Joemahoney2/Lab-3Group-6/Group 6 - Main Project 2 -  Autonomous Robot Flag Finder.pptx

Robotic Flag Finder
ECE 3333/3334-302
Instructor: William Ray
Group 6: Leader - Celina

Adam Harper - Software Engineer
Celina Luckevich - Software Engineer

Joseph Mahoney - Software Engineer
Joshua Warren - Software Engineer

## System Description

Two robots are designed to search a room for flags, retrieve the flags, and return to their home base. The robots work both cooperatively and competitively, each trying to find the most flags but ensuring all flags are found. They send video and location feed over a wifi network to a computer where instructions for driving the robots are derived from the video; these instructions are then sent back over the network to the robots. The system works autonomously, but a manual, human-controlled mode is also available.

## Last Week Deliverables

Josh
- Research Computer Vision
- Research and choose robot body

Celina
- Research Computer Vision
- Research image processing and analysis
- Research and choose ultrasonic sensor

Adam
- Research Wireless connection and user interface
- Research and choose camera

Joe
- Research Wireless connection and user interface
- Research arm and choose servo and electromagnet

## Safety Considerations

- Avoiding short circuits, causing overheating.
- Careful to operate robots at a safe speed to avoid damaging parts/people
- Exercise caution to avoid cuts from sharp wire ends
- Covering wires when cutting to keep ends from flying
- Always use proper PPE

## Division of Labor

Josh
- Rover side
- Computer Vision

Celina
- Rover side
- Computer Vision
- Image Processing and Analysis
- Flag finding/Detection

Adam
- Computer side
- Communication between robots and computer
- Communication between camera and computer

Joe
- Computer side
- GUI
- Robotic arm

## Block Diagram

9.6V
2000mAh

5 V Voltage
Regulator

Robot #2 is identical

WIFI

Uart

Physical connection

GPIO

Power

PWM

Power

PC

sensors

Robot #1

Ultrasonic
HC-SR04

3.3 V

CC3220
MCU

Wifi Camera

External rechargeable battery

3.3v

mechanical

5 V

5 V Voltage
Regulator

3.3V

9.6v

Data Computation

3.3 Volt
Regulator

Dagu - Rover 5 chassis motors

HS-422
Survo

9.6 V

3.3v 50 Hz

9 V Voltage
Regulator

Uxcell 9V 50N
Electromagnet

H-Bridge

Circuits

7.2 V

Joe Mahoney

## Texas Instruments CC3220SF

- Wi-Fi Network Processor with static or dynamic IP address
  - IPv6 and TCP/IP capable
  - Automatic connection on startup
- Ideal for IoT
- Uses 5V at 0.5A supply voltage
- 1MB Flash, 256KB RAM
- 12 bit ADC
- 27 GPIO pins
All info from TI [6]

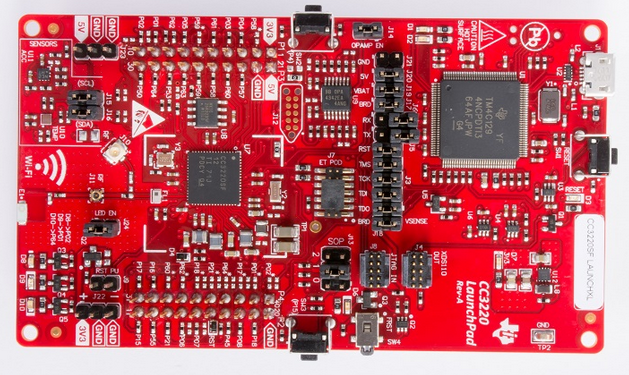
[picture p1: figure]

## Rover Base

- Dagu Rover 5
- Motor Rated Voltage: 7.2V
- Motor Stall Current: 2.5A
- Motor Stall Torque: 10Kg/cm
- Motors have 1000/3 encoders
- Speed: 1Km/hr
All info from Pololu [5]

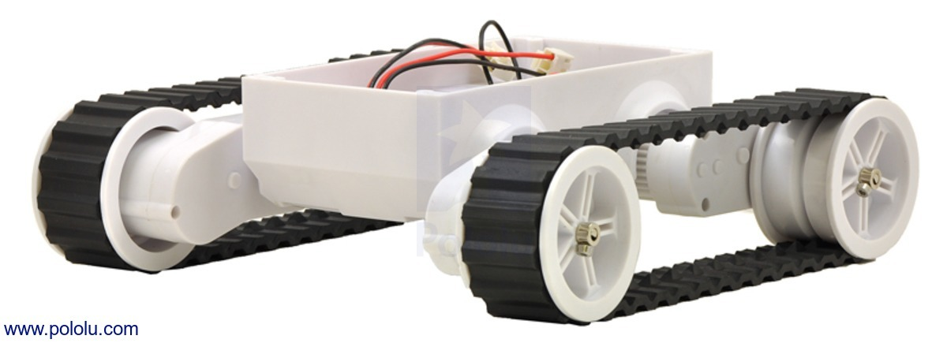
[picture p2: figure]
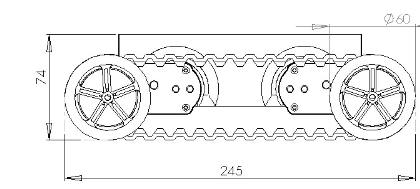
[picture p3: figure]

## Camera - eLinkSmart

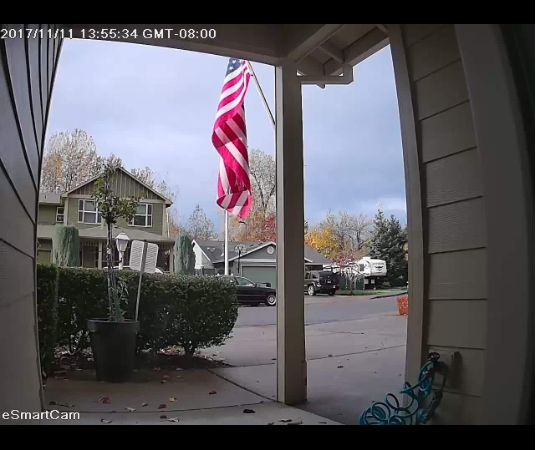
[picture p4: figure]

- IP Camera (WIFI)
- 1280 x 960p
- Rechargeable Battery
- Can be used with app (for testing)
- Connects to openCV using
camera’s IP address as input

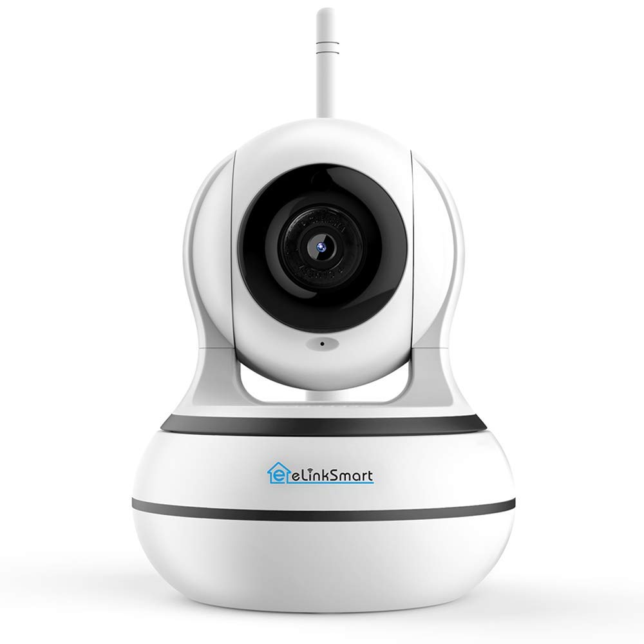
[picture p5: figure]

Images from [1]

## Arm Servo

Servo motor - HS-422
- Operating voltage 4.8 V - 6 V
- 8mA Idle current drain
- .21sec/60 degrees
Electromagnet - uxcell 9V 50N Electric Lifting Magnet
- Holding force 50N / 11.2 pound force

Joe Mahoney

## Arm Servo

- Picking up flags Process
  - Once rover is in position the electromagnet will activate attracting the metal flag pole.
  - Once the flag is secure the servo will rotate a lever arm containing the electromagnet and flag. When the flag is over the bucket/ basket located on the servo side of the rover the magnet will power down releasing the flag.
  - The servo will then reset itself to its starting position.

Joe Mahoney

## Rover Software Diagram

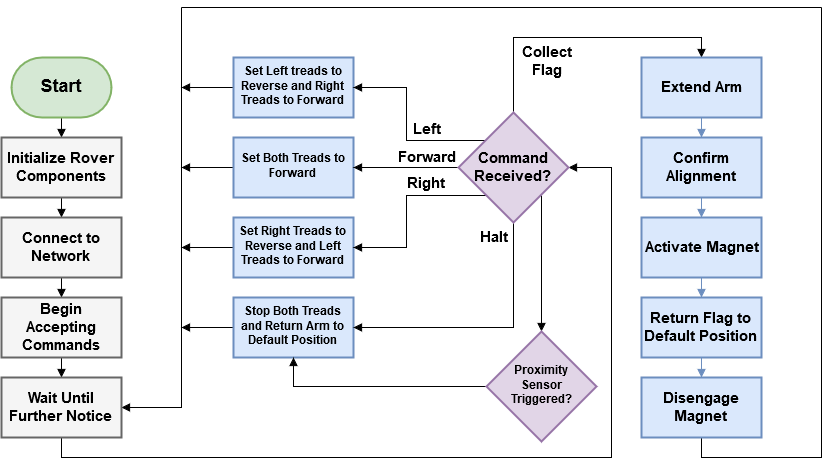
[picture p6: figure]

## Computer Vision

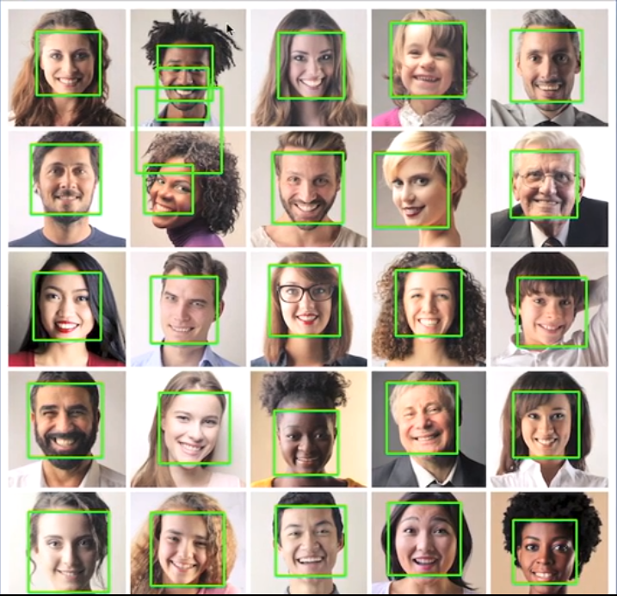
[picture p7: figure]

- Project description requires rover to use camera to view surroundings
- OpenCV has video analyzing features allowing us to scan the rovers surroundings for the flags it is looking for
- Different kinds of filters
- Usually coded in python

[2]

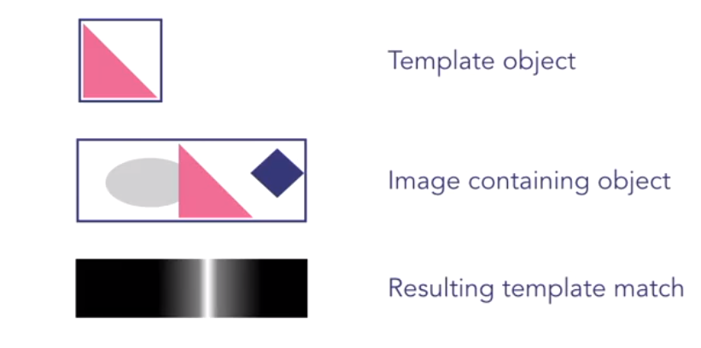
[picture p8: figure]

[2]

## Slide 14

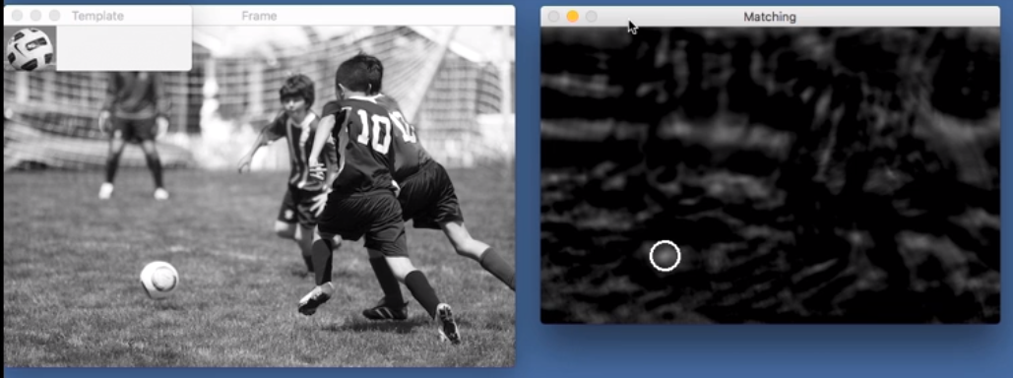
[picture p9: figure]

[2]

## Ultrasonic Sensor - HC-SR04

- Operating Voltage: 5V DC
- Operating Current: 15mA
- Measure Angle: 15°
- Ranging Distance: 2cm - 4m

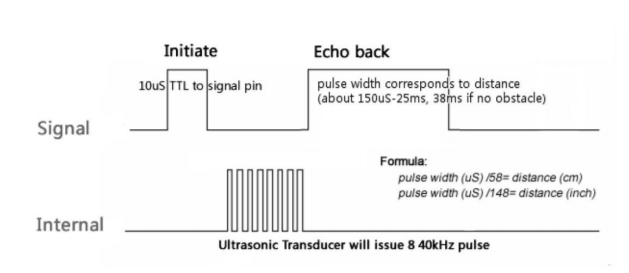
[picture p10: figure]
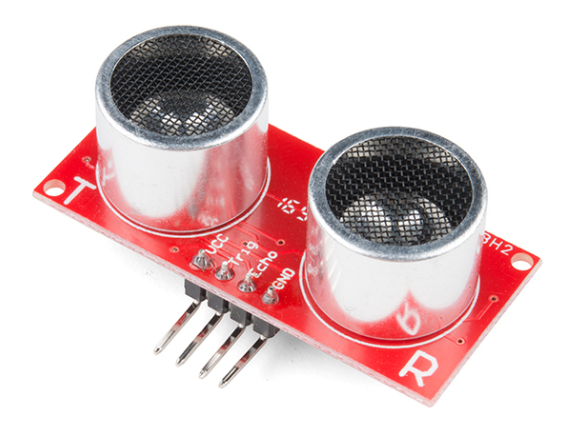
[picture p11: figure]

Range = uS / 58 -> centimeters
Range = uS / 148 -> inches
Range = high level time * velocity (340M/S) / 2
[3]

[3]

[4]

## Gantt Chart - Hardware

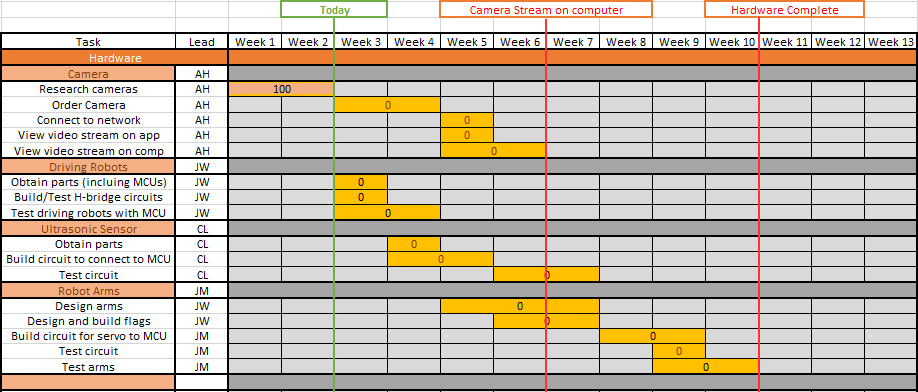
[picture p12: figure]

## Gantt Chart - Software

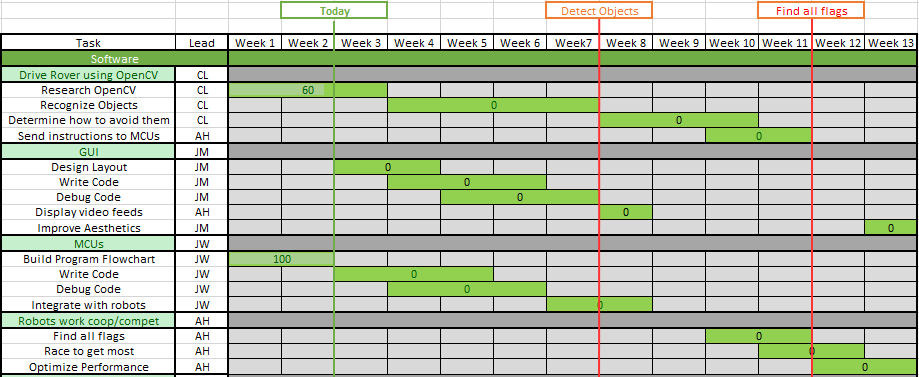
[picture p13: figure]

## Budget

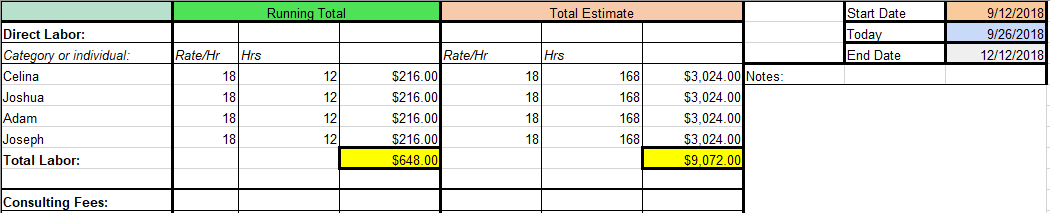
[picture p14: figure]

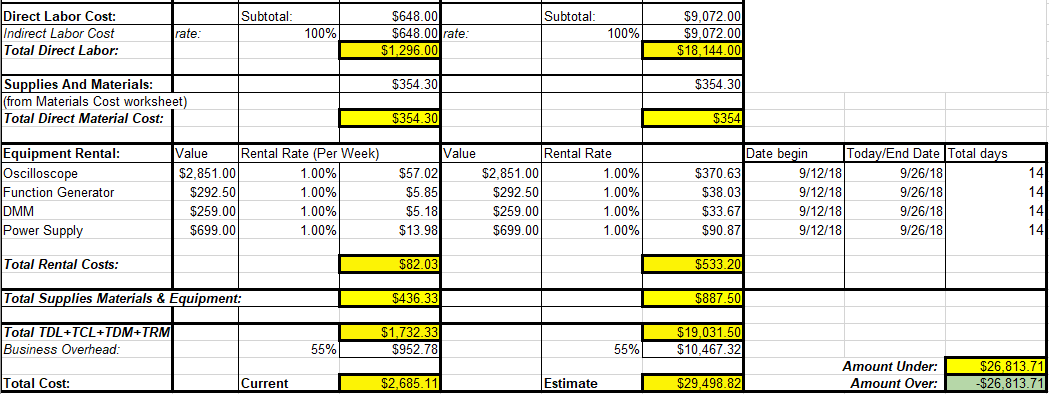
[picture p15: figure]

## Next Week Deliverables

Josh
- Begin simple image processing
- Research into controlling the CC3220 through Wi-Fi.

Celina
- Learn basic Python
- Begin simple image processing and filtering codes

Adam
- Research computer communication with IP Cameras
- Order camera
- Testing camera communication

Joe
- Research creating a user interface and communicating with the CC3220 via wifi.
- Look into displaying a video stream in a GUI

## References

1. eLinkSmart WIFI Camera https://www.amazon.com/Wireless-Security-eLinkSmart-Recording-Detection/dp/B07414BGZC
2. Crawford, P. (2017). Introduction to template matching. [online] Lynda.com - from LinkedIn. Available at: https://www.lynda.com/Python-tutorials/Introduction-template-matching/601786/660495-4.html [Accessed 21 Sep. 2018].
3. Sparkfun.com. (2018). Ultrasonic Sensor - HC-SR04 - SEN-13959 - SparkFun Electronics. [online] Available at: https://www.sparkfun.com/products/13959 [Accessed 23 Sep. 2018].
4. ITead Studio. (2018). Ultrasonic ranging module : HC-SR04 data sheet. [online] Available at: https://www.electroschematics.com/wp-content/uploads/2013/07/HC-SR04-datasheet-version-2.pdf [Accessed 24 Sep. 2018].
5. Pololu.com. (2018). Dagu Rover 5 Tracked Chassis with Encoders. [online] Available at: https://www.pololu.com/product/1551/resources [Accessed 24 Sep. 2018].
6. TI.com. (2018). SimpleLink™ Wi-Fi® CC3220SF Wireless Microcontroller. [online] Available at: http://www.ti.com/lit/ds/swas035a/swas035a.pdf [Accessed 24 Sep. 2018].

## Questions?
