Joemahoney2/Lab-3Group-6/ARM_V1V2.PNG

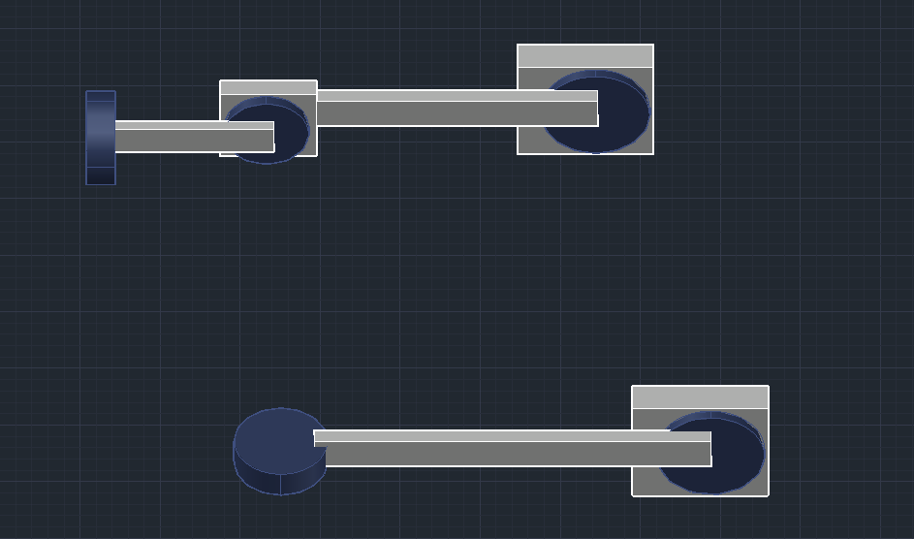
ARM_V1V2.PNG
