Joemahoney2/Lab-3Group-6/front_view.PNG

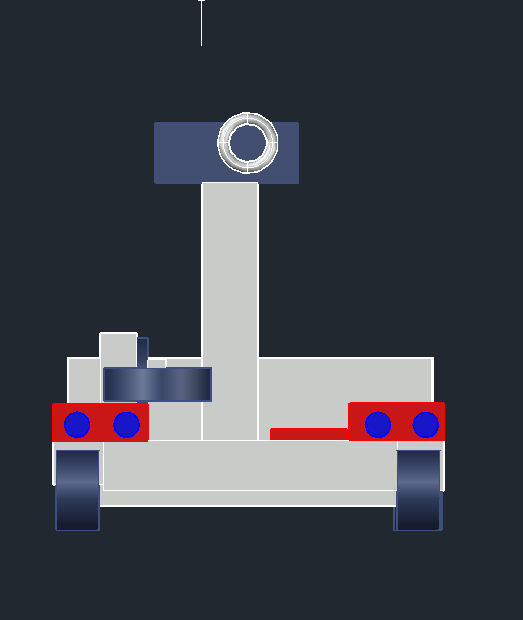
front_view.PNG
