Joemahoney2/Lab-3Group-6/GUI template.png

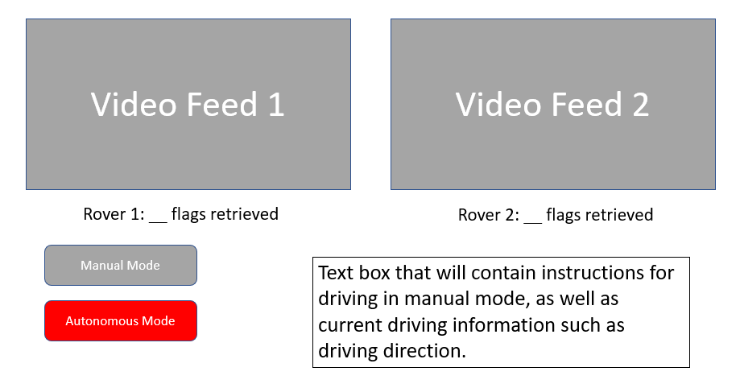
GUI template.png
