Joemahoney2/Lab-3Group-6/power.PNG

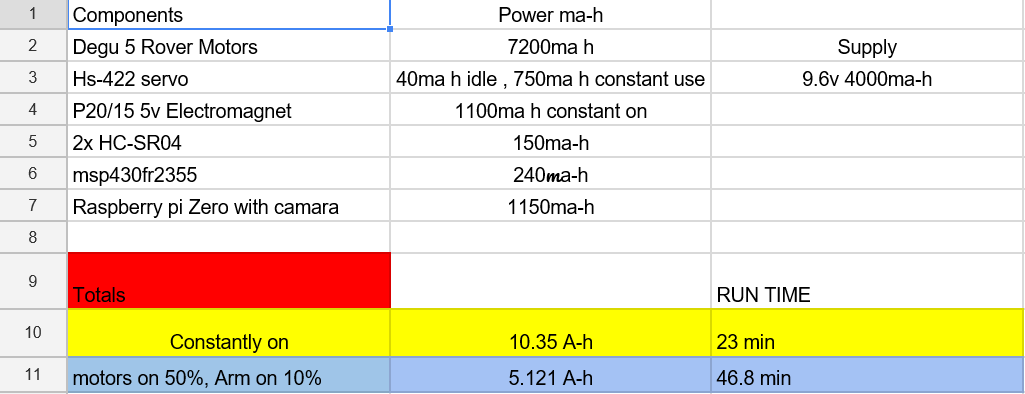
power.PNG
