Joemahoney2/Lab-3Group-6/top_view.PNG

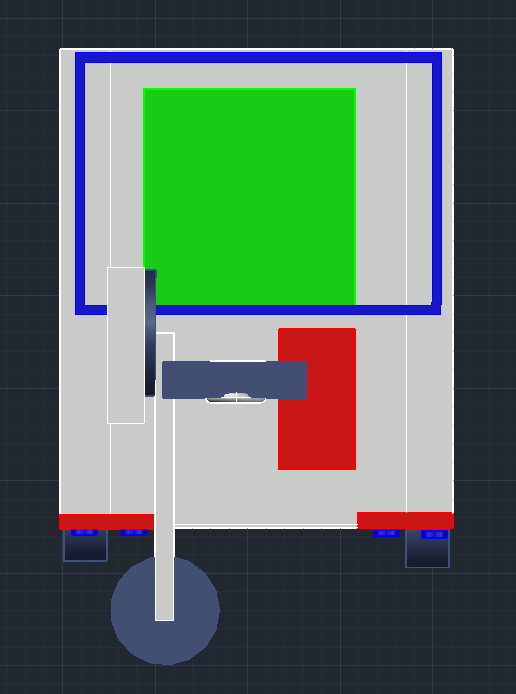
top_view.PNG
