Joemahoney2/Lab-3Group-6/uperleft_view.PNG

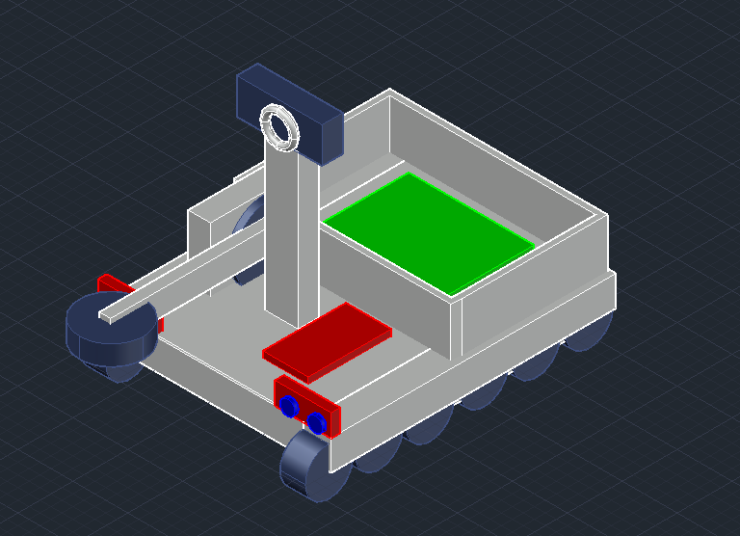
uperleft_view.PNG
