Joemahoney2/Lab-3Group-6/List of parts.docx

Rover body

- https://www.amazon.com/Dagu-Rover-5-Tracked-Chassis/dp/B012NNLW5I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
- https://www.amazon.com/DLBOT-Aluminum-All-Metal-Obstacle-surmounting-Detection/dp/B07H7HTBFJ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
- We can checkout a Dagu rover 5 body from the stockroom

Electromagnet

https://www.adafruit.com/product/3872

Arm servo

- https://www.amazon.com/Hitec-RCD-USA-31422-Standard/dp/B00B88FIZ0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
- Or we could go all out: https://www.amazon.com/LewanSoul-Real-Time-Feedback-Bearing-Brackets/dp/B0748BQ49M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

Microcontroller

- Simplelink CC3220
- Certainly open to suggestions

Ultrasonic sensor

- ??
- https://www.sparkfun.com/products/9494 2x??
- https://www.sparkfun.com/products/13959

Wifi Camera

- https://www.amazon.com/Wireless-Security-eLinkSmart-Recording-Detection/dp/B07414BGZC
- https://www.newegg.com/Product/Product.aspx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
- https://www.amazon.com/dp/B0762MB2TD/ref=cm_sw_r_other_apa_Cf9QBbMNS8AYN

Rover battery/rechargeable

- https://www.amazon.com/Tenergy-Capacity-Rechargeable-Batteries-Connector/dp/B001BBMZFU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
