Joemahoney2/Lab-3Group-6/Budget.xlsx

Sheet: Sheet1
 | Running Total |  |  | Total Estimate |  |  |  | Start Date | 2018-09-12
Direct Labor: |  |  |  |  |  |  |  | Today | 2018-10-03
Category or individual: | Rate/Hr | Hrs |  | Rate/Hr | Hrs |  |  | End Date | 2018-12-12
Celina | 18 | 40 | $720.00 | 18 | 168 | $3024.00 | Notes:
Joshua | 18 | 40 | $720.00 | 18 | 168 | $3024.00
Adam | 18 | 39 | $702.00 | 18 | 168 | $3024.00
Joseph | 18 | 31 | $558.00 | 18 | 168 | $3024.00
Total Labor: |  |  | $2142.00 |  |  | $9072.00
Consulting Fees:
Category or individual: | Rate/Hr | Hrs |  | Rate/Hr | Hrs
Lab I | 15 | 0 | $0.00 | 15 | 0 | $0.00
Lab II | 18 | 0 | $0.00 | 20 | 0 | $0.00
Lab III | 18 | 0 | $0.00 | 25 | 2 | $50.00
Lab IV & V | 25 | 1 | $25.00 | 35 | 5 | $175.00
Lab Tutors | 40 | 0 | $0.00 | 40 | 0 | $0.00
Lab Assistants | 40 | 0 | $0.00 | 40 | 0 | $0.00
Mr. Woodcock | 100 | 0 | $0.00 | 100 | 0 | $0.00
Instructor | 200 | 0 | $0.00 | 200 | 2 | $400.00
Total Contract Labor: |  |  | $25.00 |  |  | $625.00
Direct Labor Cost: |  | Subtotal: | $2142.00 |  | Subtotal: | $9072.00
Indirect Labor Cost | rate: | 100% | $2142.00 | rate: | 100% | $9072.00
Total Direct Labor: |  |  | $4284.00 |  |  | $18144.00
Supplies And Materials: |  |  | $342.30 |  |  | $342.30
(from Materials Cost worksheet)
Total Direct Material Cost: |  |  | $342.30 |  |  | $342.3
Equipment Rental: | Value | Rental Rate (Per Week) |  | Value | Rental Rate |  | Date begin | Today/End Date | Total days
Oscilloscope | $2851.00 | 1.00% | $85.53 | $2851.00 | 1.00% | $370.63 | 2018-09-12 | 2018-10-03 | 21
Function Generator | $292.50 | 1.00% | $8.78 | $292.50 | 1.00% | $38.02 | 2018-09-12 | 2018-10-03 | 21
DMM | $259.00 | 1.00% | $7.77 | $259.00 | 1.00% | $33.67 | 2018-09-12 | 2018-10-03 | 21
Power Supply | $699.00 | 1.00% | $20.97 | $699.00 | 1.00% | $90.87 | 2018-09-12 | 2018-10-03 | 21
Total Rental Costs: |  |  | $123.05 |  |  | $533.20
Total Supplies Materials & Equipment: |  |  | $465.35 |  |  | $875.50
Total TDL+TCL+TDM+TRM |  |  | $4749.35 |  |  | $19019.49
Business Overhead: |  | 55% | $2612.14 |  | 55% | $10460.72
 |  |  |  |  |  |  | Amount Under: |  | $22118.73
Total Cost: |  | Current | $7361.48 |  | Estimate | $29480.22 | Amount Over: |  | -$22118.73

Sheet: Materials Cost
Item | Cost | Quantity | Notes/Website | Purchase date | Total | Part Number | Total Cost
Rover Chassis | $40.00 | 2 | amazon.com |  | $80.00 | ROV5-1 | Total Cost
Electromagnet | $3.63 | 2 | amazon.com |  | $7.26 |  | $342.30
Servo | $13.95 | 2 | amazon.com |  | $27.90 | HS-422 (31422)
CC3220 MCU Launchpad | $51.76 | 2 | mouser.com |  | $103.52 | CC3220SF
Ultrasonic Sensor | $9.32 | 2 | robotshop.com |  | $18.64 | HC-SR04
IP Camera | $35.99 | 2 | amazon.com |  | $71.98
Battery Pack | $33.00 | 1 | amazon.com |  | $33.00 | Pack of 2
 |  |  |  |  | $0.00
 |  |  |  |  | $0.00
 |  |  |  |  | $0.00
 |  |  |  |  | $0.00
 |  |  |  |  | $0.00
 |  |  |  |  | $0.00
 |  |  |  |  | $0.00
 |  |  |  |  | $0.00
 |  |  |  |  | $0.00
 |  |  |  |  | $0.00
 |  |  |  |  | $0.00
 |  |  |  |  | $0.00
 |  |  |  |  | $0.00
 |  |  |  |  | $0.00
 |  |  |  |  | $0.00
 |  |  |  |  | $0.00
 |  |  |  |  | $0.00
 |  |  |  |  | $0.00
 |  |  |  |  | $0.00
 |  |  |  |  | $0.00
 |  |  |  |  | $0.00
 |  |  |  |  | $0.00
 |  |  |  |  | $0.00
 |  |  |  |  | $0.00
 |  |  |  |  | $0.00
 |  |  |  |  | $0.00
 |  |  |  |  | $0.00
 |  |  |  |  | $0.00
 |  |  |  |  | $0.00
 |  |  |  |  | $0.00
 |  |  |  |  | $0.00
 |  |  |  |  | $0.00
 |  |  |  |  | $0.00
 |  |  |  |  | $0.00
 |  |  |  |  | $0.00
 |  |  |  |  | $0.00
 |  |  |  |  | $0.00
 |  |  |  |  | $0.00
 |  |  |  |  | $0.00
 |  |  |  |  | $0.00
 |  |  |  |  | $0.00
 |  |  |  |  | $0.00
 |  |  |  |  | $0.00
 |  |  |  |  | $0.00
 |  |  |  |  | $0.00
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
 |  |  |  |  | $0.00
 |  |  |  |  | $0.00
 |  |  |  |  | $0.00
 |  |  |  |  | $0.00
 |  |  |  |  | $0.00
 |  |  |  |  | $0.00
 |  |  |  |  | $0.00
 |  |  |  |  | $0.00
 |  |  |  |  | $0.00
 |  |  |  |  | $0.00
 |  |  |  |  | $0.00
 |  |  |  |  | $0.00
 |  |  |  |  | $0.00
 |  |  |  |  | $0.00

Sheet: Labor Hours
 | Celina | Joshua | Adam | Joseph | Lab I | Lab II | Lab III | Lab IV & V | Lab Tutors | Lab Assistants | Mr. Woodcock | Instructor |  | Total Hours
2018-09-12 | 0 | 0 | 0 | 0 | 0 | 0 | 0 | 0 | 0 | 0 | 0 | 0 | Celina | 40
2018-09-13 | 0 | 0 | 0 | 0 | 0 | 0 | 0 | 0 | 0 | 0 | 0 | 0 | Joshua | 40
2018-09-14 | 0 | 0 | 0 | 0 | 0 | 0 | 0 | 0 | 0 | 0 | 0 | 0 | Adam | 39
2018-09-15 | 0 | 0 | 0 | 0 | 0 | 0 | 0 | 0 | 0 | 0 | 0 | 0 | Joseph | 36
2018-09-16 | 0 | 0 | 0 | 0 | 0 | 0 | 0 | 0 | 0 | 0 | 0 | 0 | Lab I | 0
2018-09-17 | 0 | 0 | 0 | 0 | 0 | 0 | 0 | 0 | 0 | 0 | 0 | 0 | Lab II | 0
2018-09-18 | 0 | 0 | 0 | 0 | 0 | 0 | 0 | 0 | 0 | 0 | 0 | 0 | Lab III | 0
2018-09-19 | 0 | 0 | 0 | 0 | 0 | 0 | 0 | 0 | 0 | 0 | 0 | 0 | Lab IV & V | 1
2018-09-20 | 0 | 0 | 0 | 0 | 0 | 0 | 0 | 0 | 0 | 0 | 0 | 0 | Lab Tutors | 0
2018-09-21 | 0 | 0 | 0 | 0 | 0 | 0 | 0 | 0 | 0 | 0 | 0 | 0 | Lab Assistants | 0
2018-09-22 | 0 | 0 | 0 | 0 | 0 | 0 | 0 | 0 | 0 | 0 | 0 | 0 | Mr. Woodcock | 0
2018-09-23 | 0 | 0 | 0 | 0 | 0 | 0 | 0 | 0 | 0 | 0 | 0 | 0 | Instructor | 0
2018-09-24 | 0 | 0 | 0 | 0 | 0 | 0 | 0 | 0 | 0 | 0 | 0 | 0
2018-09-25 | 0 | 0 | 0 | 0 | 0 | 0 | 0 | 0 | 0 | 0 | 0 | 0
2018-09-26 | 12 | 12 | 12 | 12 | 0 | 0 | 0 | 0 | 0 | 0 | 0 | 0
2018-09-27 | 0 | 0 | 3 | 0 | 0 | 0 | 0 | 0 | 0 | 0 | 0 | 0
2018-09-28 | 4 | 0 | 0 | 0 | 0 | 0 | 0 | 0 | 0 | 0 | 0 | 0
2018-09-29 | 5 | 0 | 0 | 0 | 0 | 0 | 0 | 0 | 0 | 0 | 0 | 0
2018-09-30 | 0 | 0 | 0 | 0 | 0 | 0 | 0 | 0 | 0 | 0 | 0 | 0
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
2018-12-08 | 0 | 0 | 0 | 0 | 0 | 0 | 0 | 0 | 0 | 0 | 0 | 0
2018-12-09 | 0 | 0 | 0 | 0 | 0 | 0 | 0 | 0 | 0 | 0 | 0 | 0
2018-12-10 | 0 | 0 | 0 | 0 | 0 | 0 | 0 | 0 | 0 | 0 | 0 | 0
2018-12-11 | 0 | 0 | 0 | 0 | 0 | 0 | 0 | 0 | 0 | 0 | 0 | 0
2018-12-12 | 0 | 0 | 0 | 0 | 0 | 0 | 0 | 0 | 0 | 0 | 0 | 0
