Joemahoney2/Lab-3Group-6/L3G6_PCB.brd

## EAGLE design L3G6_PCB.brd (2018-11-16)

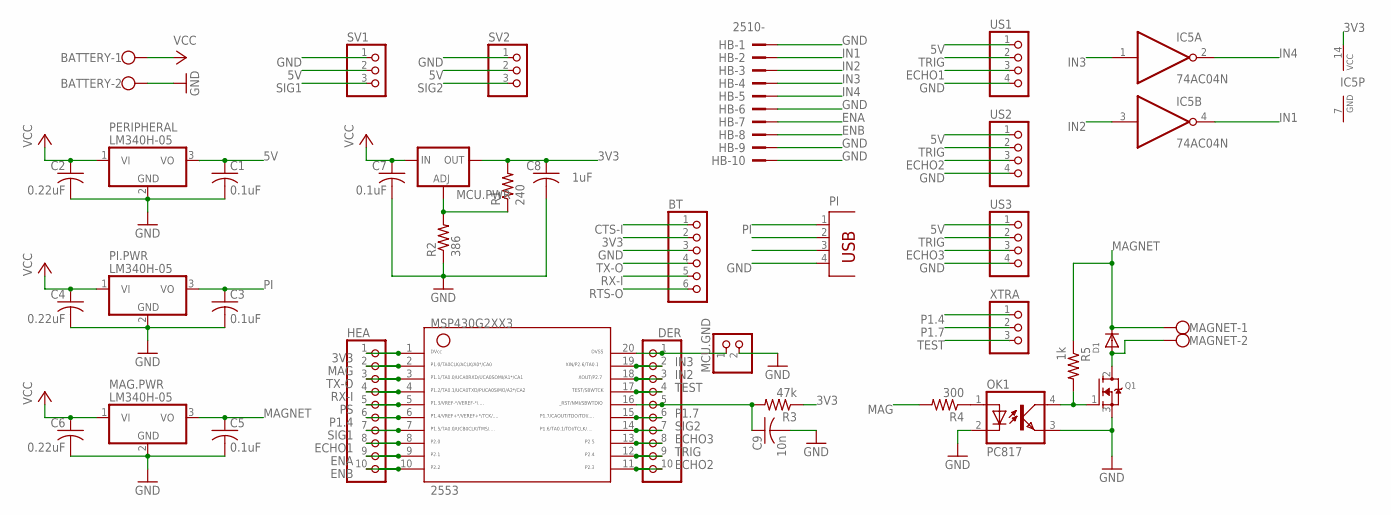
[picture p22: schematic L3G6_PCB.sch]

Parts:
2553: G2XX3---N20; N20
BATTERY: W237-102
BT: PINHD-1X6; 1X06
C1, C3, C5, C7: 0.1uF; C050-025X075
C2, C4, C6: 0.22uF; C050-025X075
C8: 1uF; C050-025X075
C9: 10n; C050-025X075
D1: DIODEDO-1N4148; DO-1N4148
DER: PINHD-1X10; 1X10
HB: 2510-; PAK100/2500-10
HEA: PINHD-1X10; 1X10
IC5: 74AC04N; DIL14
MAG.PWR: LM340H-05; TO220H
MAGNET: W237-102
MCU.GND: PINHD-1X2; 1X02
MCU.PWR: LM317TS; 317TS
OK1: PC817; DIL04
PERIPHERAL: LM340H-05; TO220H
PI: PN87520
PI.PWR: LM340H-05; TO220H
Q1: MOSFET-NGDS_TO220V; TO220V
R1: 240; 0207/10
R2: 386; 0207/10
R3: 47k; 0207/10
R4: 300; 0207/10
R5: 1k; 0207/10
SV1, SV2: PINHD-1X3; 1X03
US1, US2, US3: PINHD-1X4; 1X04
XTRA: PINHD-1X3; 1X03

Connections:
3V3: 2553.1, BT.2, C8.1, HEA.1, IC5.14 (VCC), MCU.PWR.2 (OUT), R1.2, R3.1
5V: C1.1, PERIPHERAL.3 (VO), SV1.2, SV2.2, US1.1, US2.1, US3.1
CTS-I: BT.1
ECHO1: 2553.8, HEA.8, US1.3
ECHO2: 2553.11, DER.10, US2.3
ECHO3: 2553.13, DER.8, US3.3
ENA: 2553.9, HB.7, HEA.9
ENB: 2553.10, HB.8, HEA.10
GND: BATTERY.2, BT.3, C1.2, C2.2, C3.2, C4.2, C5.2, C6.2, C7.2, C8.2, C9.2, HB.1, HB.6, HB.9, HB.10, IC5.7 (GND), MAG.PWR.2 (GND), MCU.GND.2, OK1.2 (C), OK1.3 (EMIT), PERIPHERAL.2 (GND), PI.4, PI.PWR.2 (GND), Q1.3 (S), R2.1, SV1.1, SV2.1, US1.4, US2.4, US3.4
IN1: HB.2, IC5.4 (O)
IN2: 2553.18, DER.3, HB.3, IC5.3 (I)
IN3: 2553.19, DER.2, HB.4, IC5.1 (I)
IN4: HB.5, IC5.2 (O)
MAG: 2553.2, HEA.2, R4.2
MAGNET: C5.1, D1.C, MAG.PWR.3 (VO), MAGNET.1, R5.1
unnamed: 2553.16, C9.1, DER.5, R3.2
unnamed: MCU.PWR.1 (ADJ), R1.1, R2.2
unnamed: OK1.1 (A), R4.1
unnamed: 2553.20, DER.1, MCU.GND.1
unnamed: D1.A, MAGNET.2, Q1.2 (D)
unnamed: OK1.4 (COL), Q1.1 (G), R5.2
P1.4: 2553.6, HEA.6, XTRA.1
P1.7: 2553.15, DER.6, XTRA.2
PI: C3.1, PI.1, PI.PWR.3 (VO)
PS: 2553.5, HEA.5
RTS-O: BT.6
RX-I: 2553.4, BT.5, HEA.4
SIG1: 2553.7, HEA.7, SV1.3
SIG2: 2553.14, DER.7, SV2.3
TEST: 2553.17, DER.4, XTRA.3
TRIG: 2553.12, DER.9, US1.2, US2.2, US3.2
TX-O: 2553.3, BT.4, HEA.3
VCC: BATTERY.1, C2.1, C4.1, C6.1, C7.1, MAG.PWR.1 (VI), MCU.PWR.3 (IN), PERIPHERAL.1 (VI), PI.PWR.1 (VI)

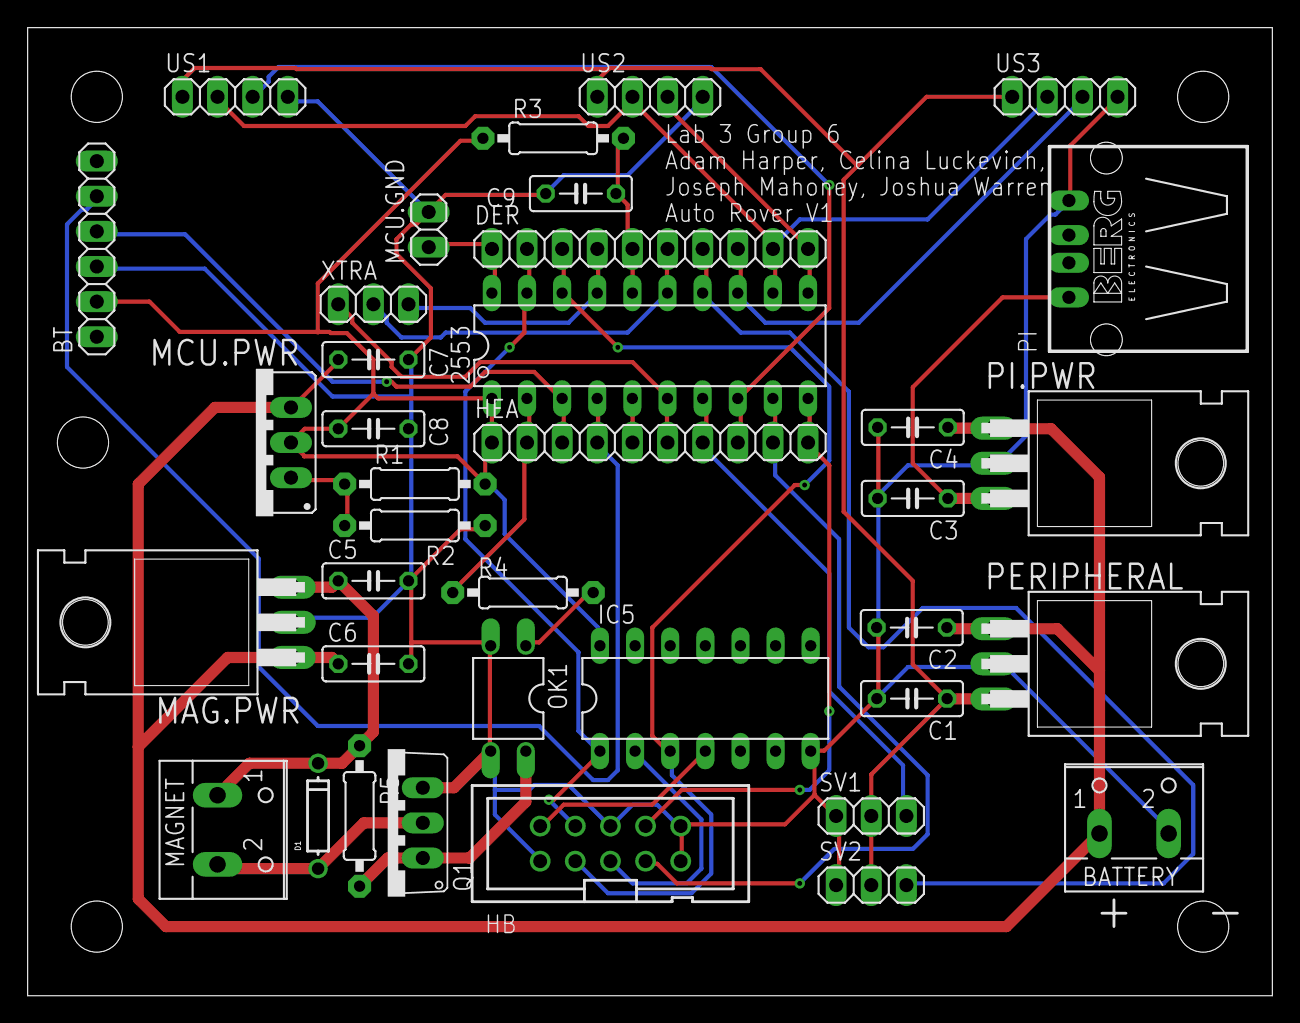
[picture p23: board L3G6_PCB.brd from above]

Board: 2 copper layers, 90.0 x 70.0 mm, 37 parts (0 on the bottom side), 31 nets.
