Joemahoney2/Lab-3Group-6/(commit log)

2018-10-15 Gantt Chart
    [Gantt Chart.xlsx]
2018-10-16 Basic filter and stream
2018-10-17 Current Rover Command Code
    For use on the MSP430G2553
2018-10-24 Create Servo control
2018-10-24 Update Servo control
2018-10-29 GUI and driving using Object Detection (maybe latency issues)
    [Object_Detection.py, Top.py]
2018-11-12 MSP code - WORKING with arm - 11-12-2018
2018-11-16 Rover PCB Files
    PCB EAGLE files. 11/15/2018
    [L3G6_PCB.brd, L3G6_PCB.sch]
2018-11-16 MSP code 11-16-18 (Pressure Sensors working)
